anweiteck/2stageCMOSOpAmp/ttsky25a-opamp/docs/info.md

<!---

This file is used to generate your project datasheet. Please fill in the information below and delete any unused
sections.

You can also include images in this folder and reference them in the markdown. Each image must be less than
512 kb in size, and the combined size of all images must be less than 1 MB.
-->

## How it works

Simple 2 stage CMOS Op Amp with Miller compensation.

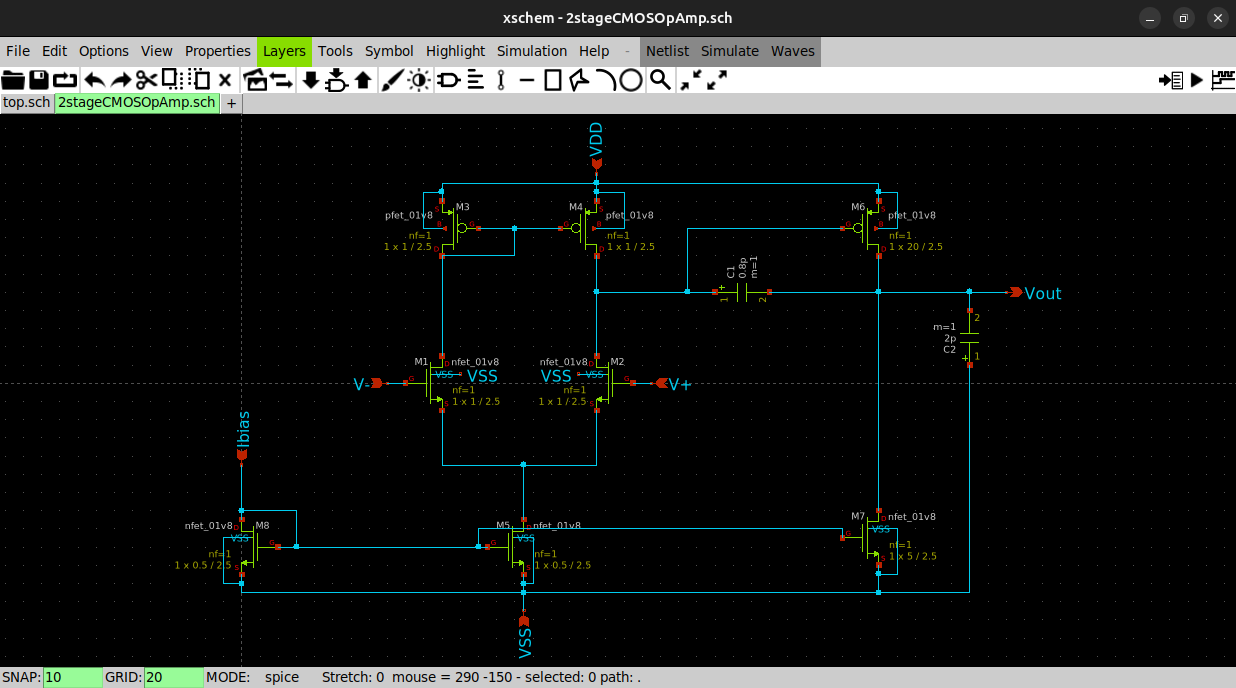
[picture p1: ttsky25a-opamp/schematic.png]
image info


## How to test

- Feed a current of 8uA to Ibias.
- Add a 2pF capacitor to Vout, C2 in the schematic is an external capacitor that needs to be added
- The op amp needs a DC power supply of +1.8V to work
- The differential inputs are V+ and V-, while the output of the op amp is Vout.

## External hardware

No external hardware requried
