anweiteck/2stageCMOSOpAmp/ttsky25a-opamp/test/overview.xlsx

Sheet: parameters
 | calculated | actual
open loop gain | 50 | 50 | dB
open loop PM | 60 | 70 | deg
GBW | 5 | 5 | MHz
SR | 10 | ~8 | V/us

Sheet: effect of C_L
with C_L | w/o C_L
