anweiteck/2stageCMOSOpAmp/ttsky25a-opamp/test/v2_Cc0.5pF/sample_waves/a0.01_f10k_gain100.pdf

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

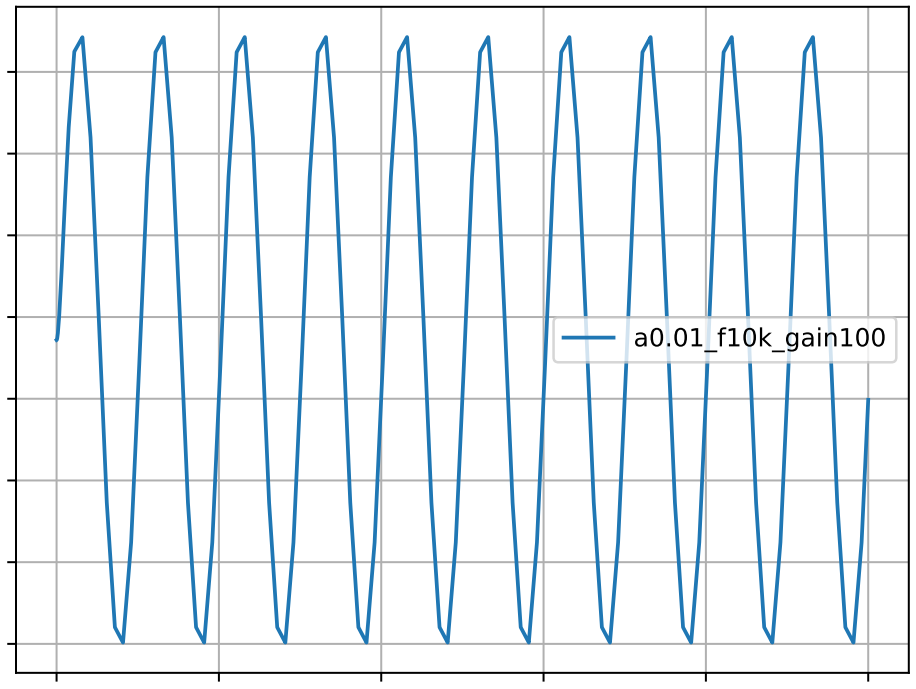
[picture p16: figure]
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
