anweiteck/2stageCMOSOpAmp/ttsky25a-opamp/test/v1_Cc3pF/effect of C_L/Vout no C_L.png

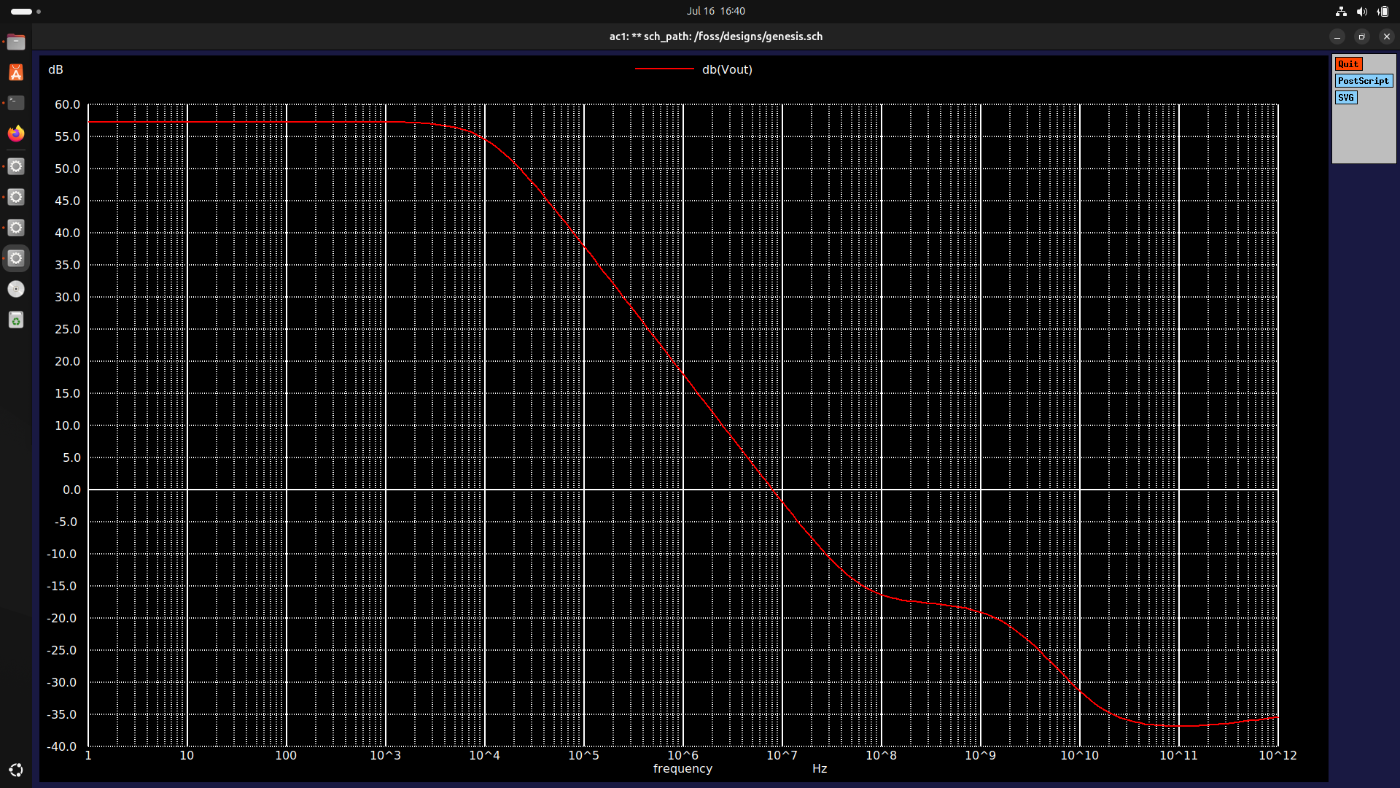
ttsky25a-opamp/test/v1_Cc3pF/effect of C_L/Vout no C_L.png
