anweiteck/2stageCMOSOpAmp/ttsky25a-opamp/test/v2_Cc0.5pF/sample_waves/a0.01_f1k_gain100-1.png

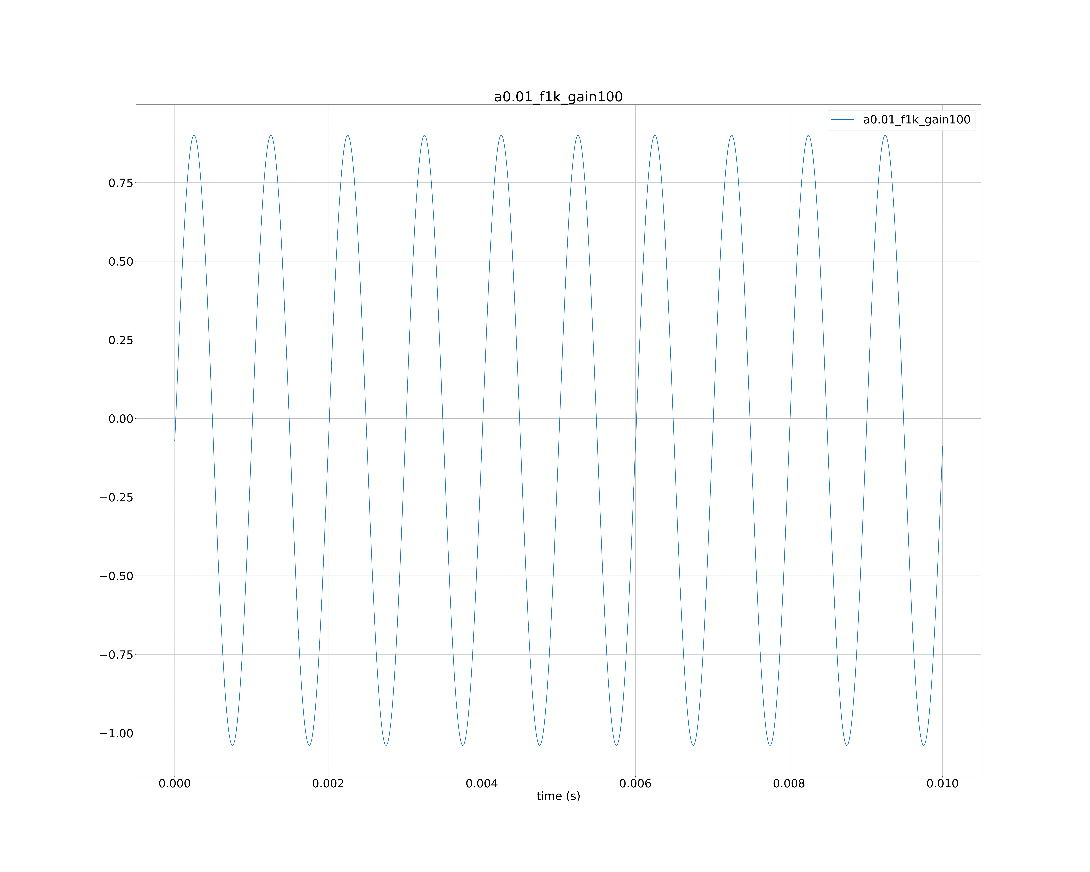
ttsky25a-opamp/test/v2_Cc0.5pF/sample_waves/a0.01_f1k_gain100-1.png
