anweiteck/2stageCMOSOpAmp/ttsky25a-opamp/test/v2_Cc0.5pF/sample_waves/a1.3m_f1k_gain700-1.png

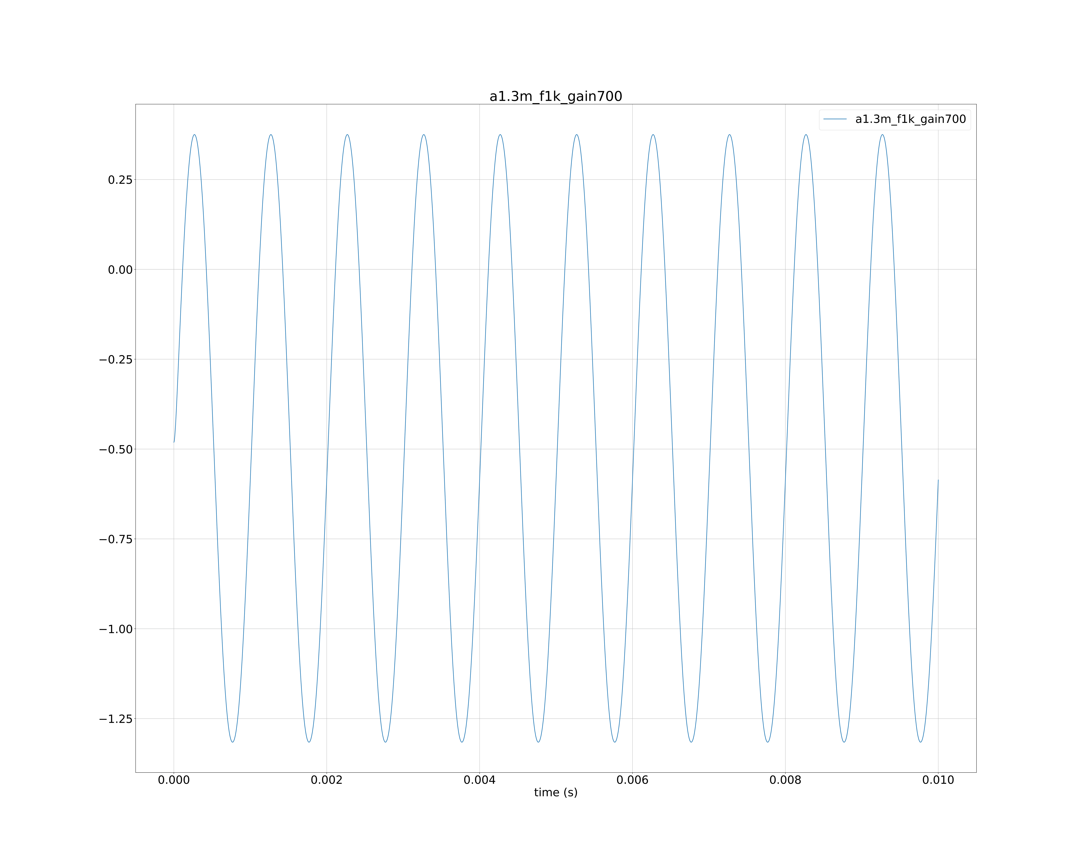
ttsky25a-opamp/test/v2_Cc0.5pF/sample_waves/a1.3m_f1k_gain700-1.png
