anweiteck/2stageCMOSOpAmp/ttsky25a-opamp/test/v3_Cc0.45pF/OpenLoop/open loop gain + PM.png

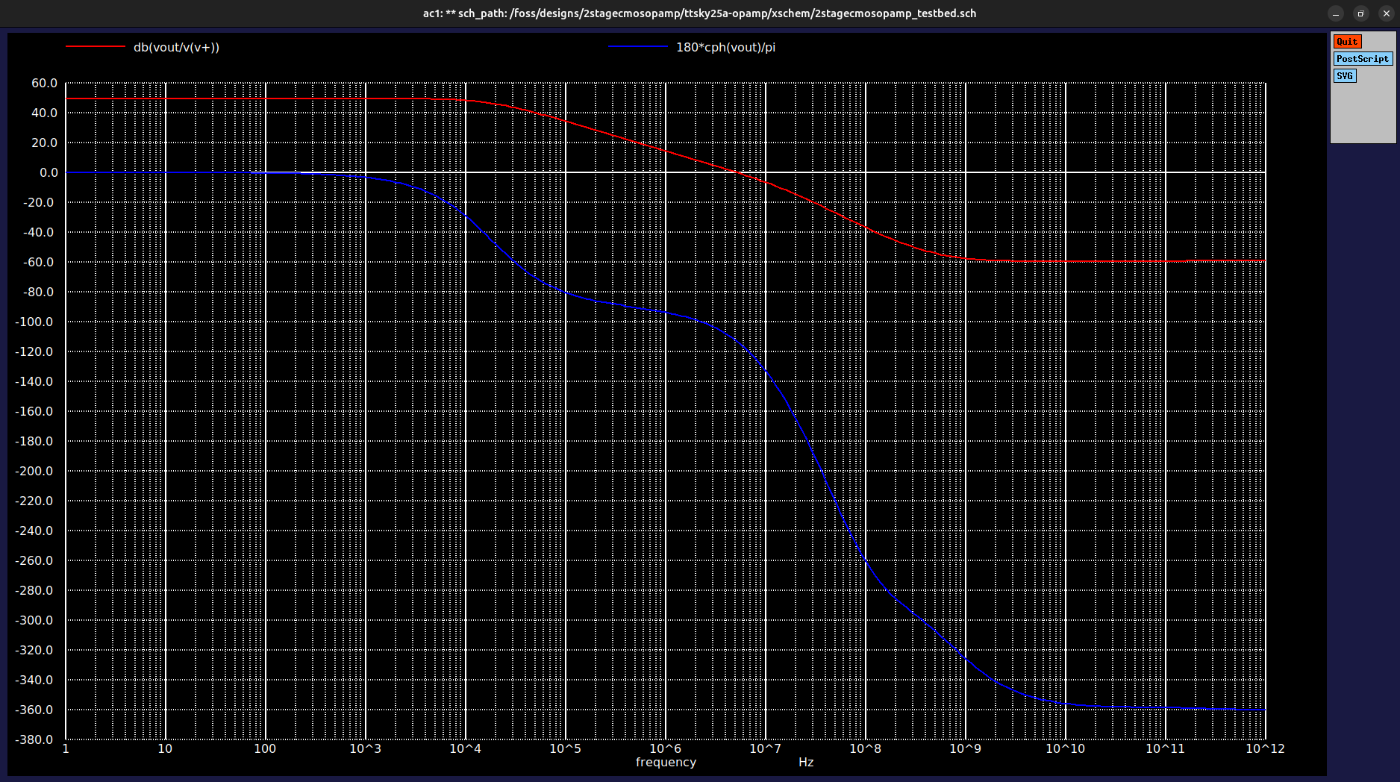
ttsky25a-opamp/test/v3_Cc0.45pF/OpenLoop/open loop gain + PM.png
