anweiteck/2stageCMOSOpAmp/ttsky25a-opamp/test/v4_Cc0.8pF/SR/SR-1.png

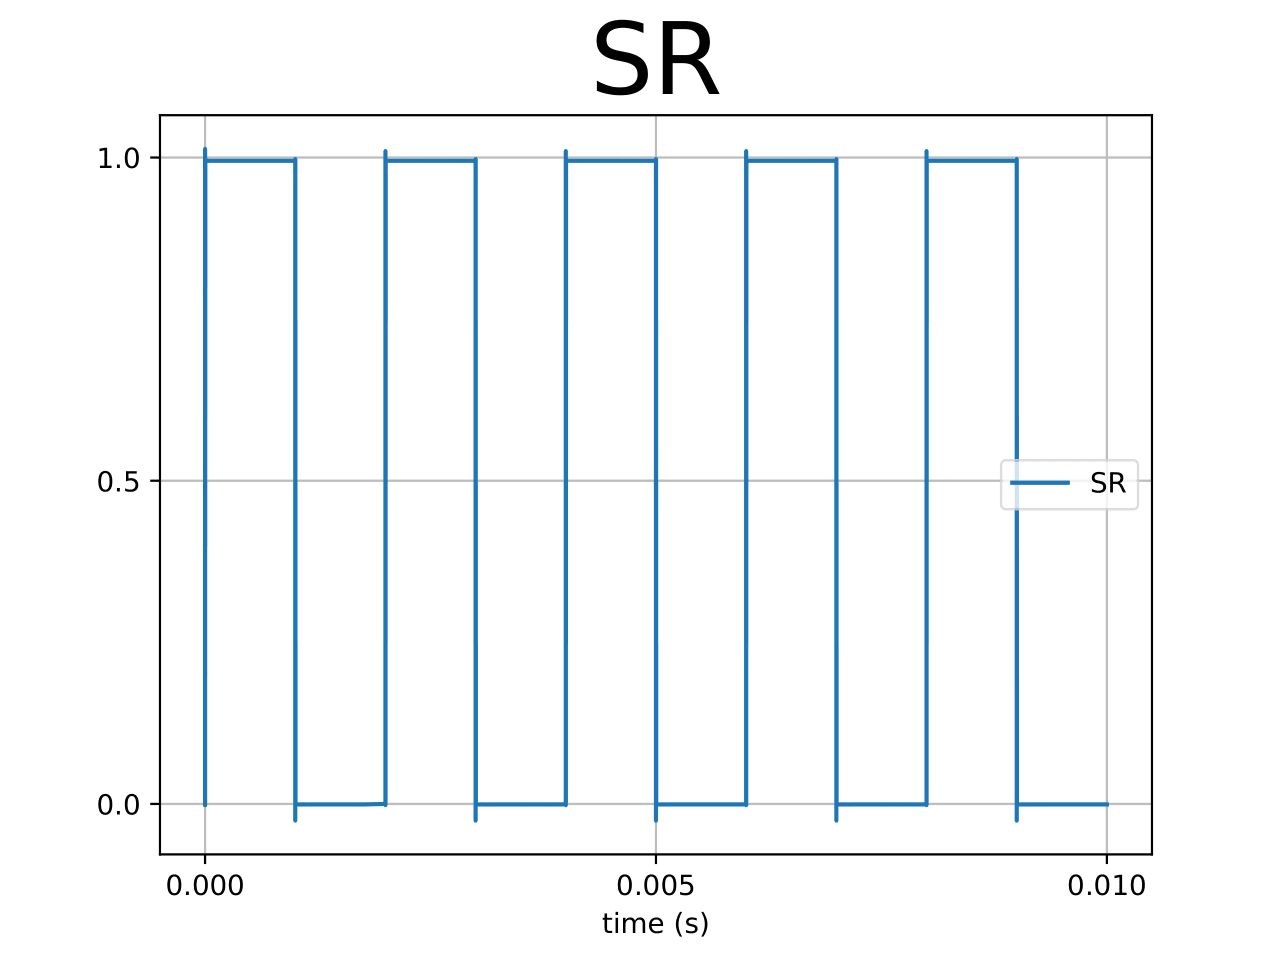
ttsky25a-opamp/test/v4_Cc0.8pF/SR/SR-1.png
