anweiteck/2stageCMOSOpAmp/ttsky25a-opamp/test/v1_Cc3pF/GainvsFreq/Frequency response of different gains.pdf

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

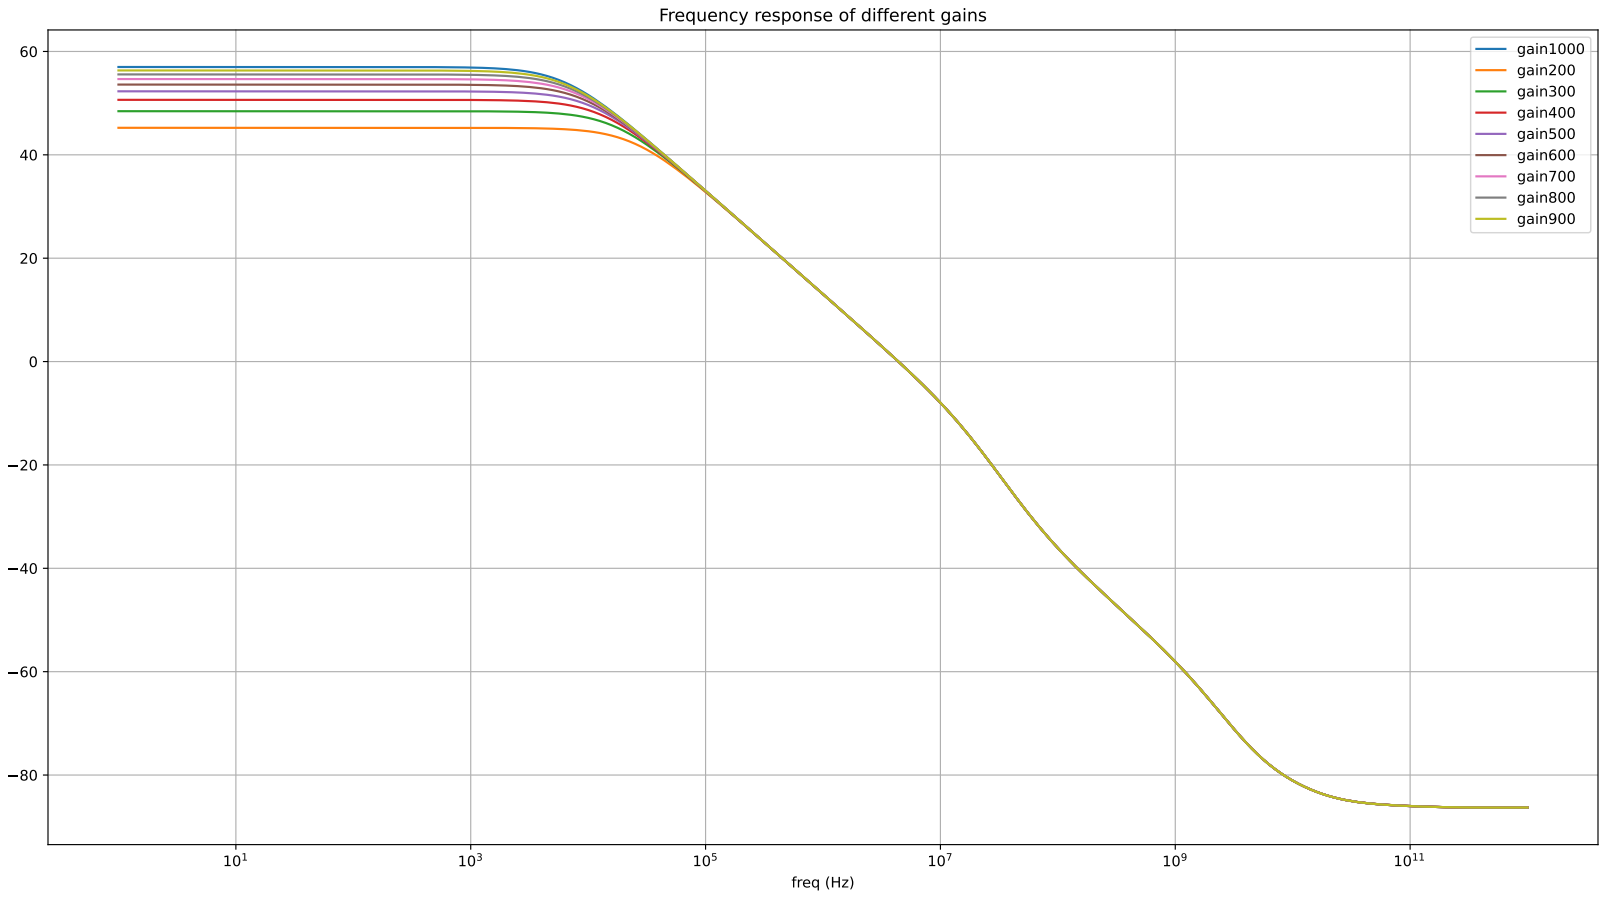
[picture p25: page 1]
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
