anweiteck/2stageCMOSOpAmp/ttsky25a-opamp/test/v2_Cc0.5pF/sample_waves/a2.5m_f1k_gain400.pdf

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

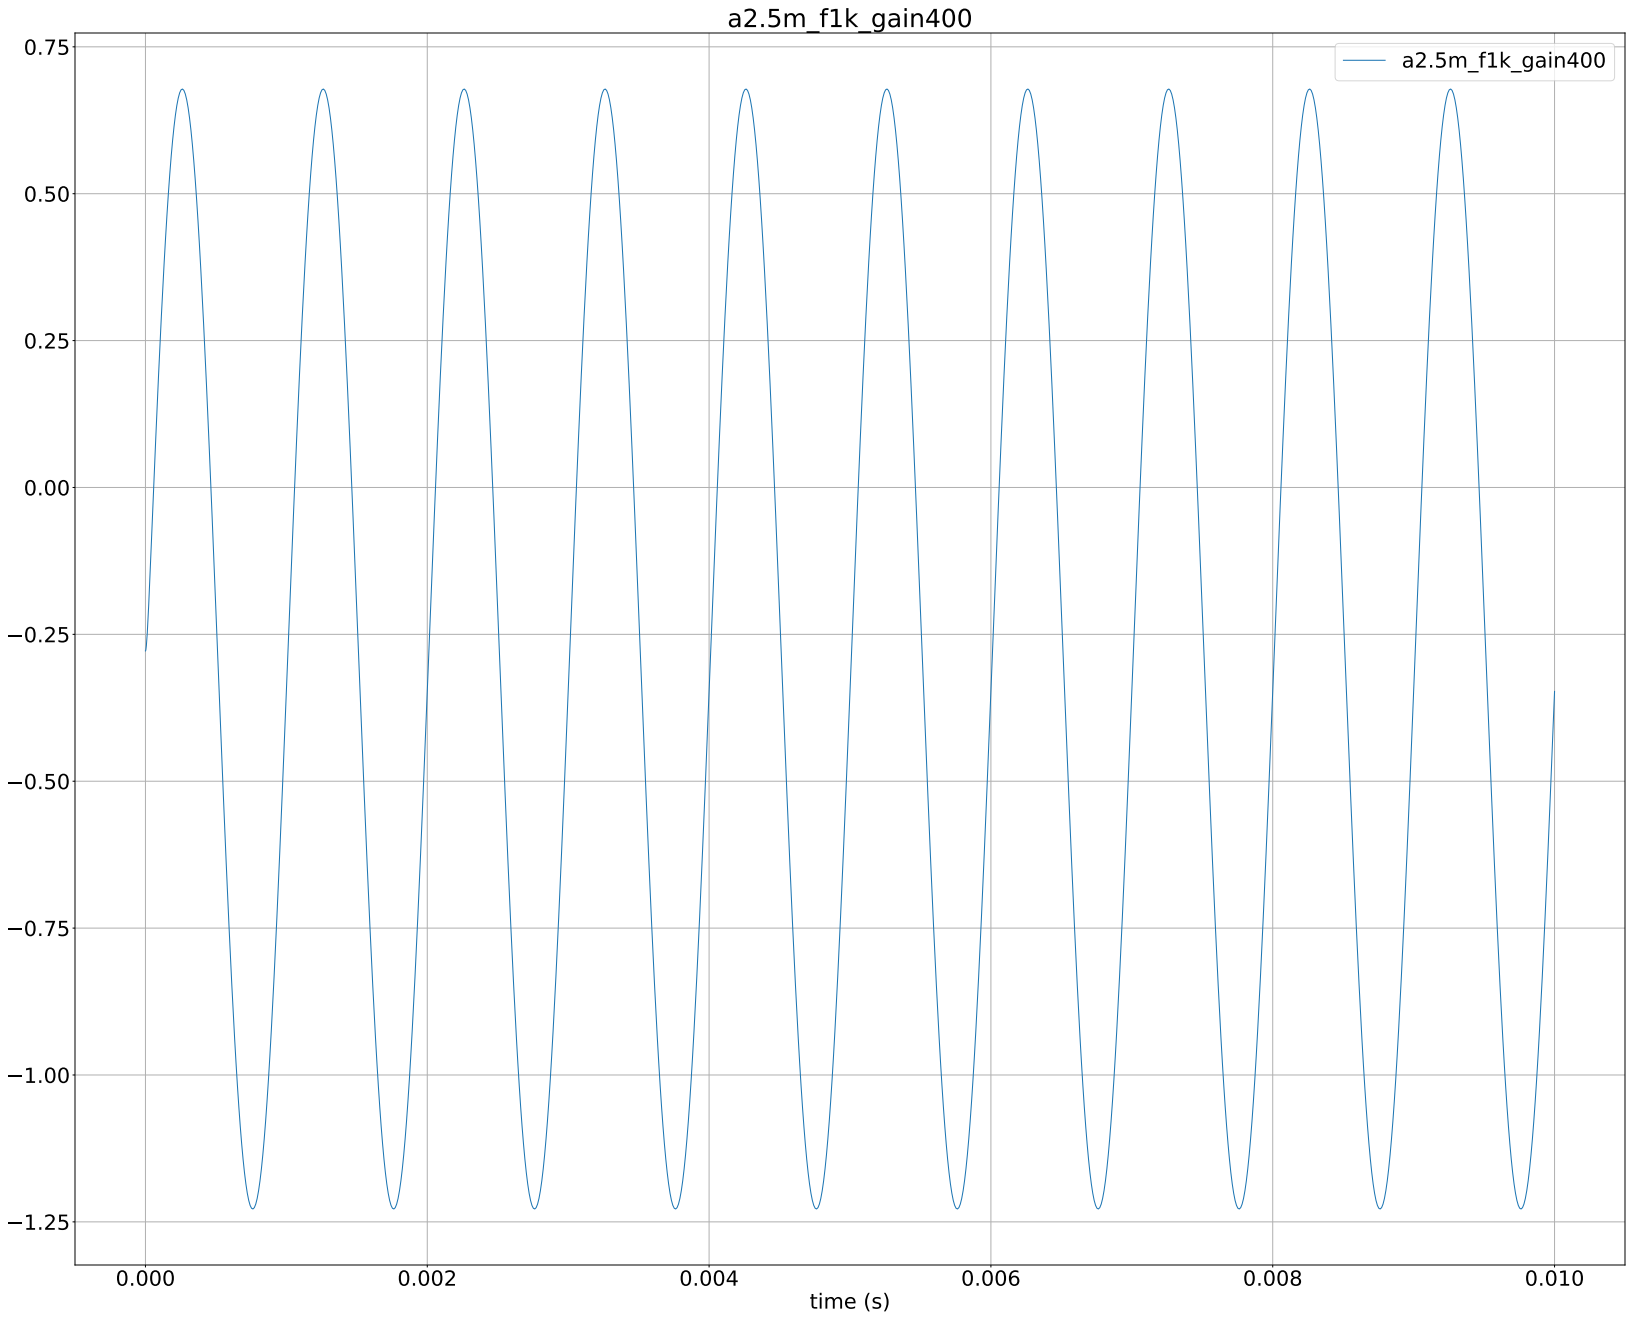
[picture p30: page 1]
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
