anweiteck/2stageCMOSOpAmp/ttsky25a-opamp/test/v3_Cc0.45pF/sample_waves/a1.3m_f10k_gain700.pdf

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

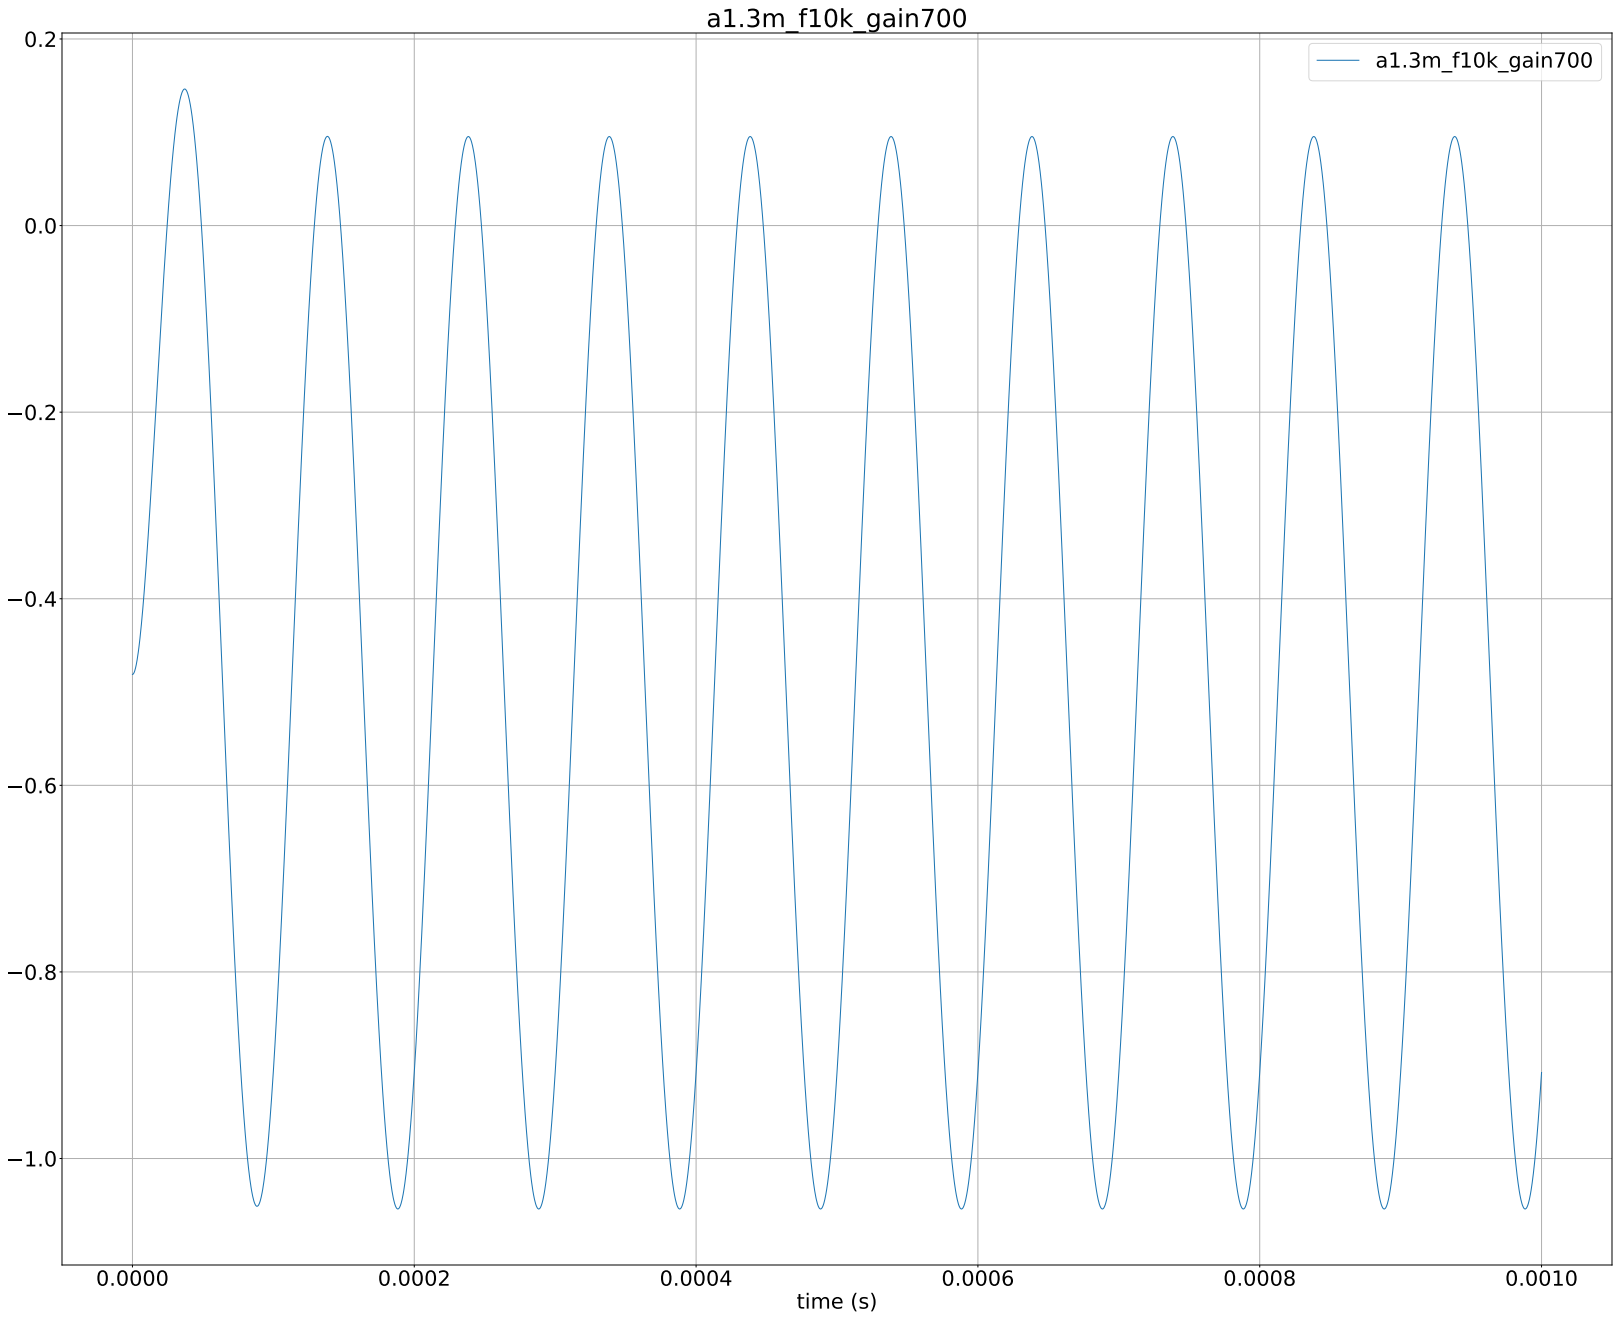
[picture p35: page 1]
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
