anweiteck/2stageCMOSOpAmp/ttsky25a-opamp/test/v3_Cc0.45pF/sample_waves/a2.5m_f1k_gain400.pdf

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

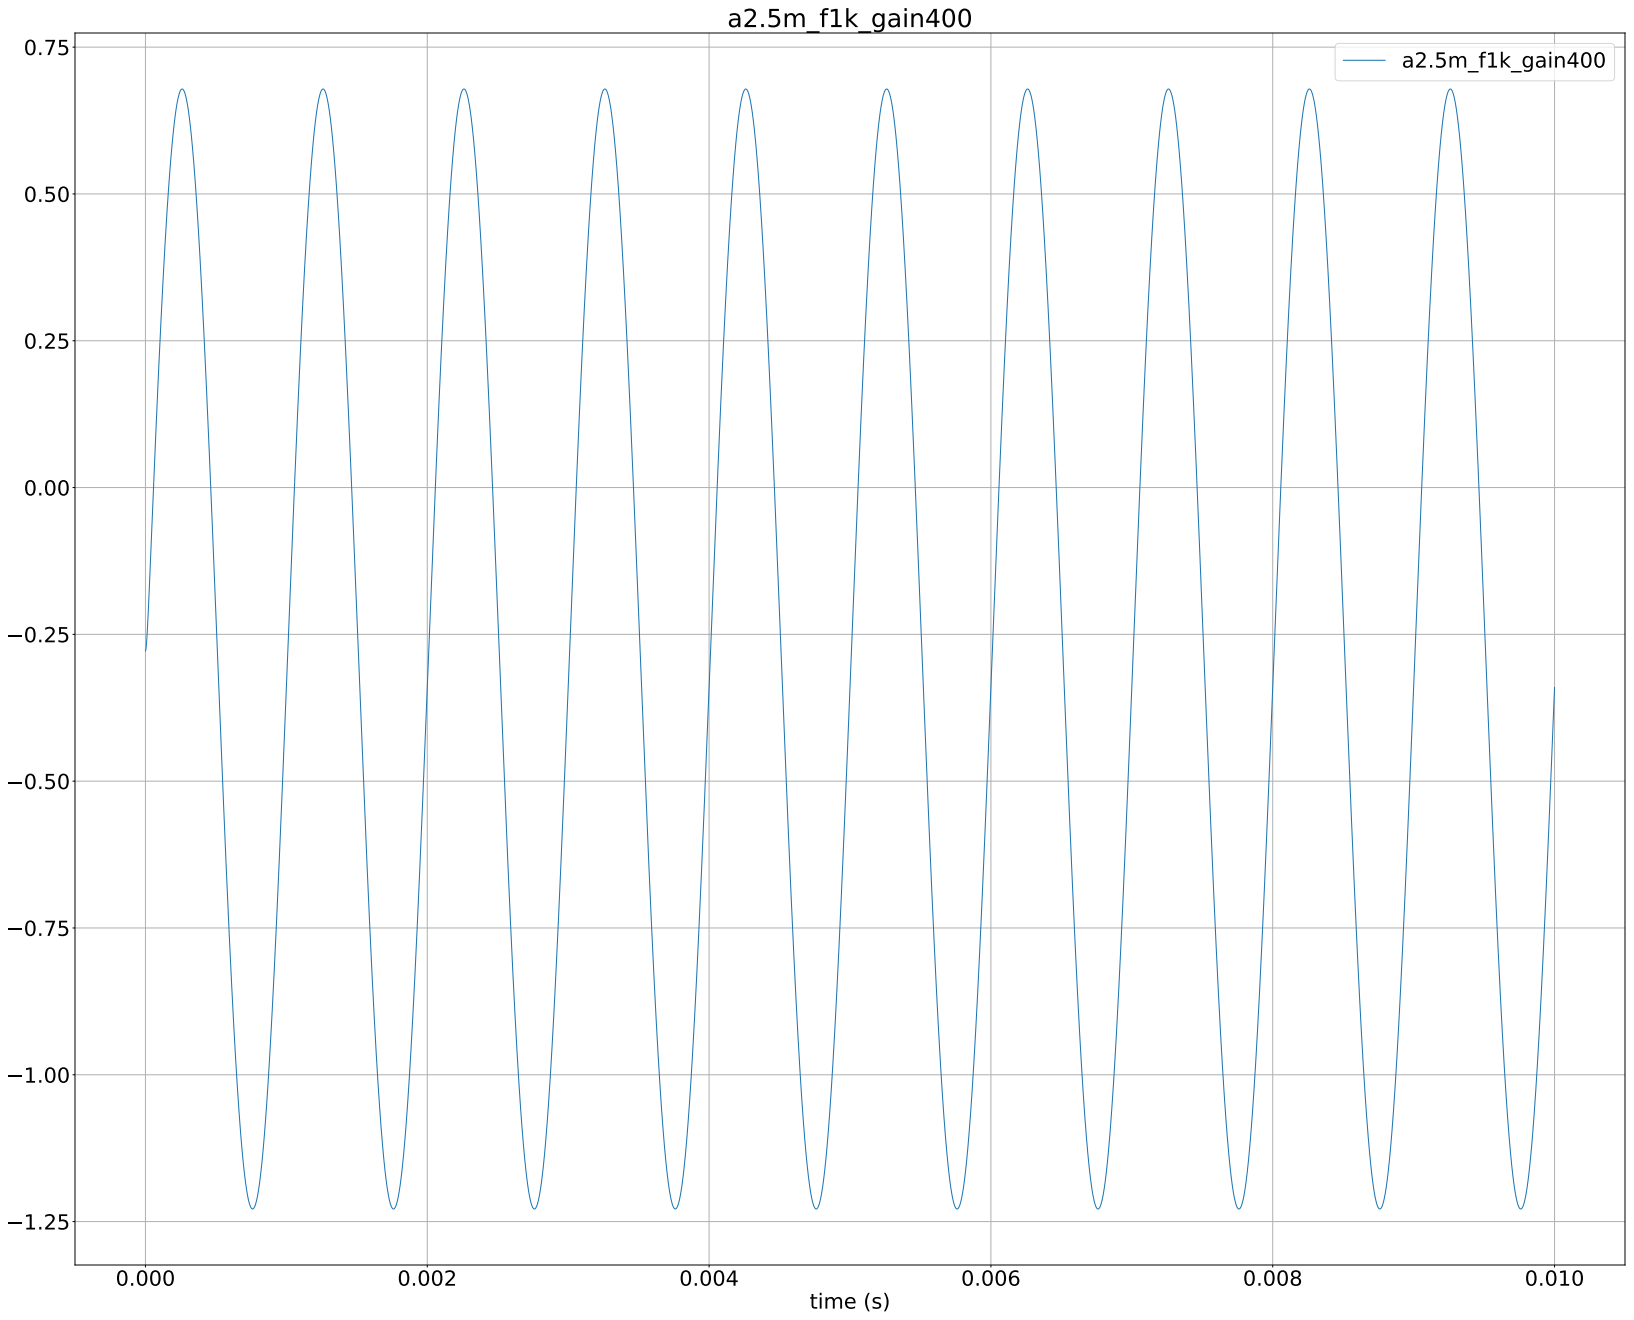
[picture p39: page 1]
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
