anweiteck/2stageCMOSOpAmp/ttsky25a-opamp/test/v3_Cc0.45pF/SR/SR.pdf

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

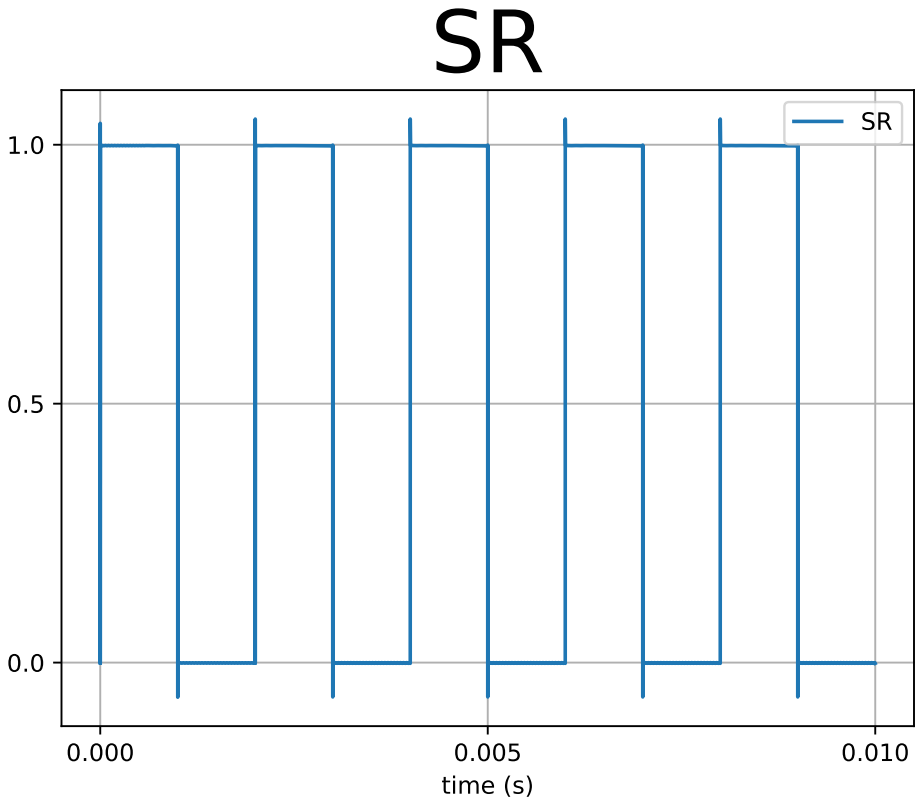
[picture p40: page 1]
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
