anweiteck/2stageCMOSOpAmp/ttsky25a-opamp/test/v4_Cc0.8pF/sample_waves/a0.01_f10k_gain100.pdf

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

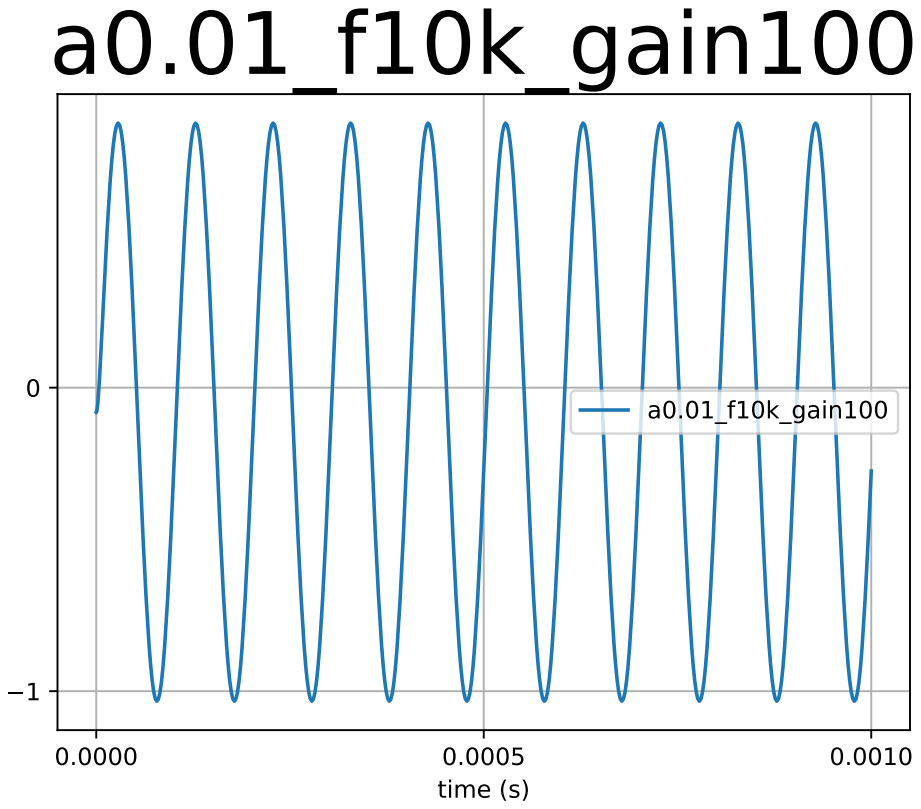
[picture p42: page 1]
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
