anweiteck/2stageCMOSOpAmp/ttsky25a-opamp/test/v4_Cc0.8pF/sample_waves/a1.3m_f1k_gain700.pdf

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

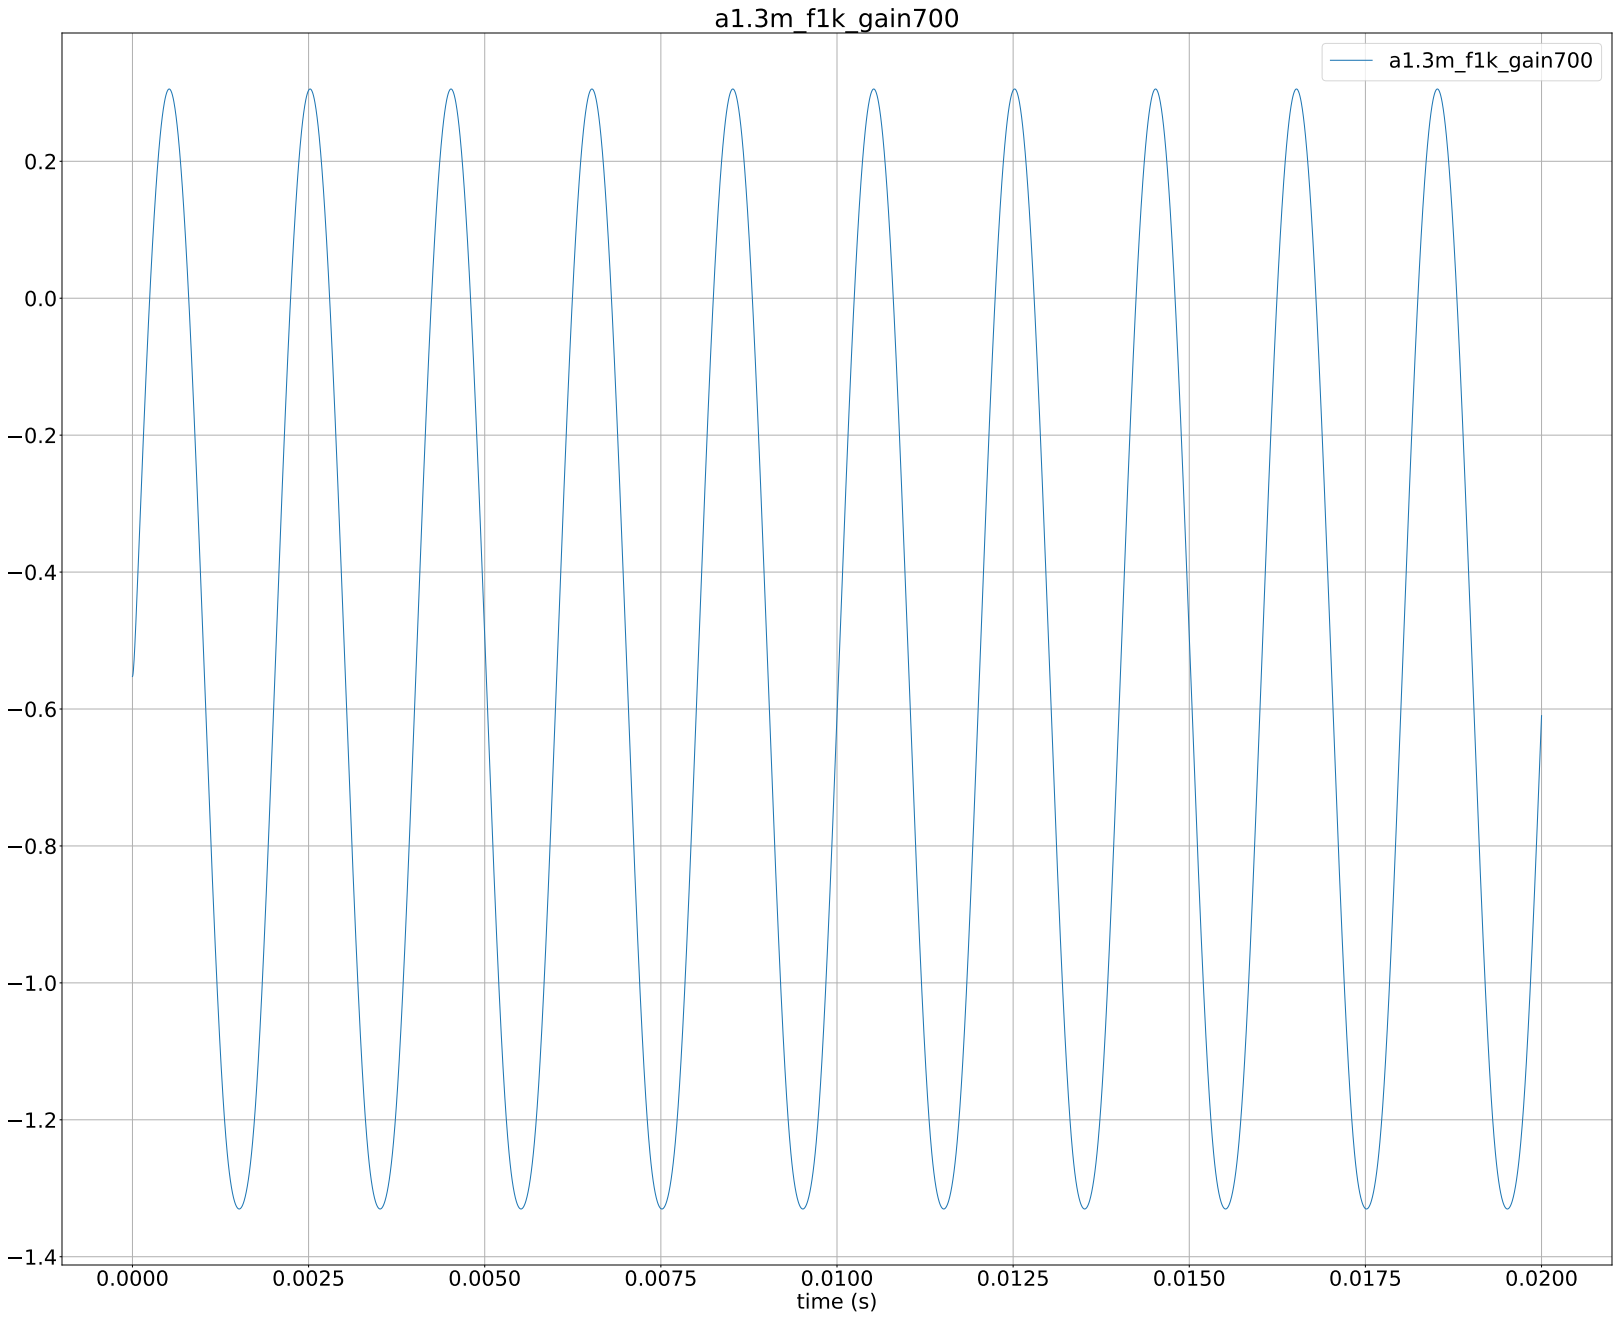
[picture p44: page 1]
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
