anweiteck/2stageCMOSOpAmp/ttsky25a-opamp/test/v4_Cc0.8pF/SR/SR.pdf

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

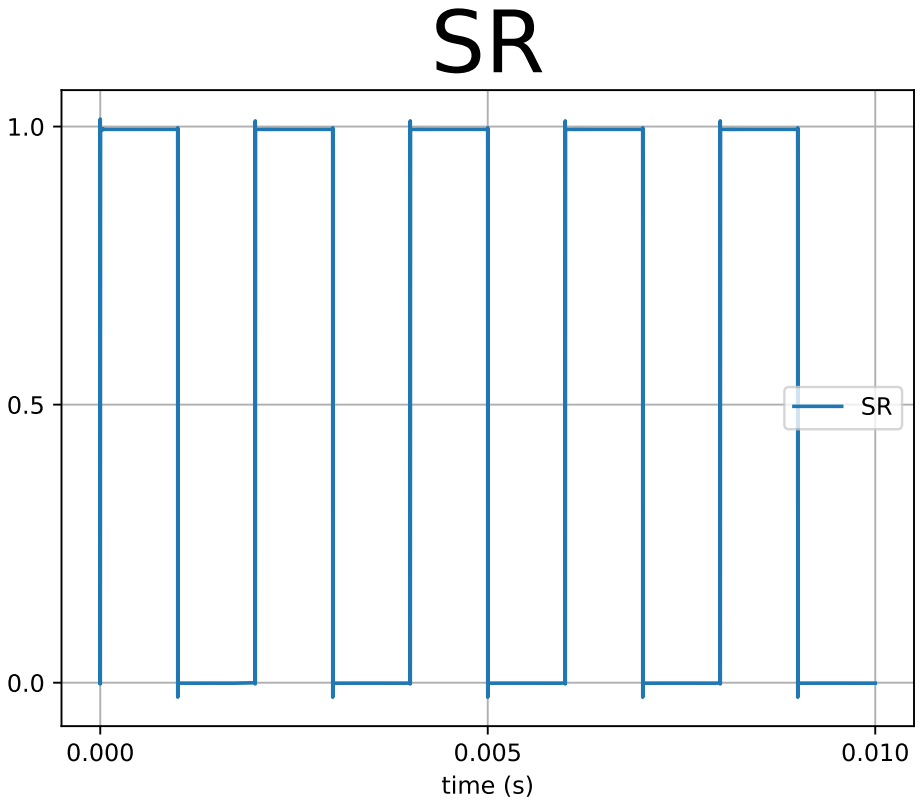
[picture p47: page 1]
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
