anweiteck/2stageCMOSOpAmp/ttsky25a-opamp/test/v4_Cc0.8pF_postlayout/comparisons/a2.5m_f10k_gain400.pdf

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

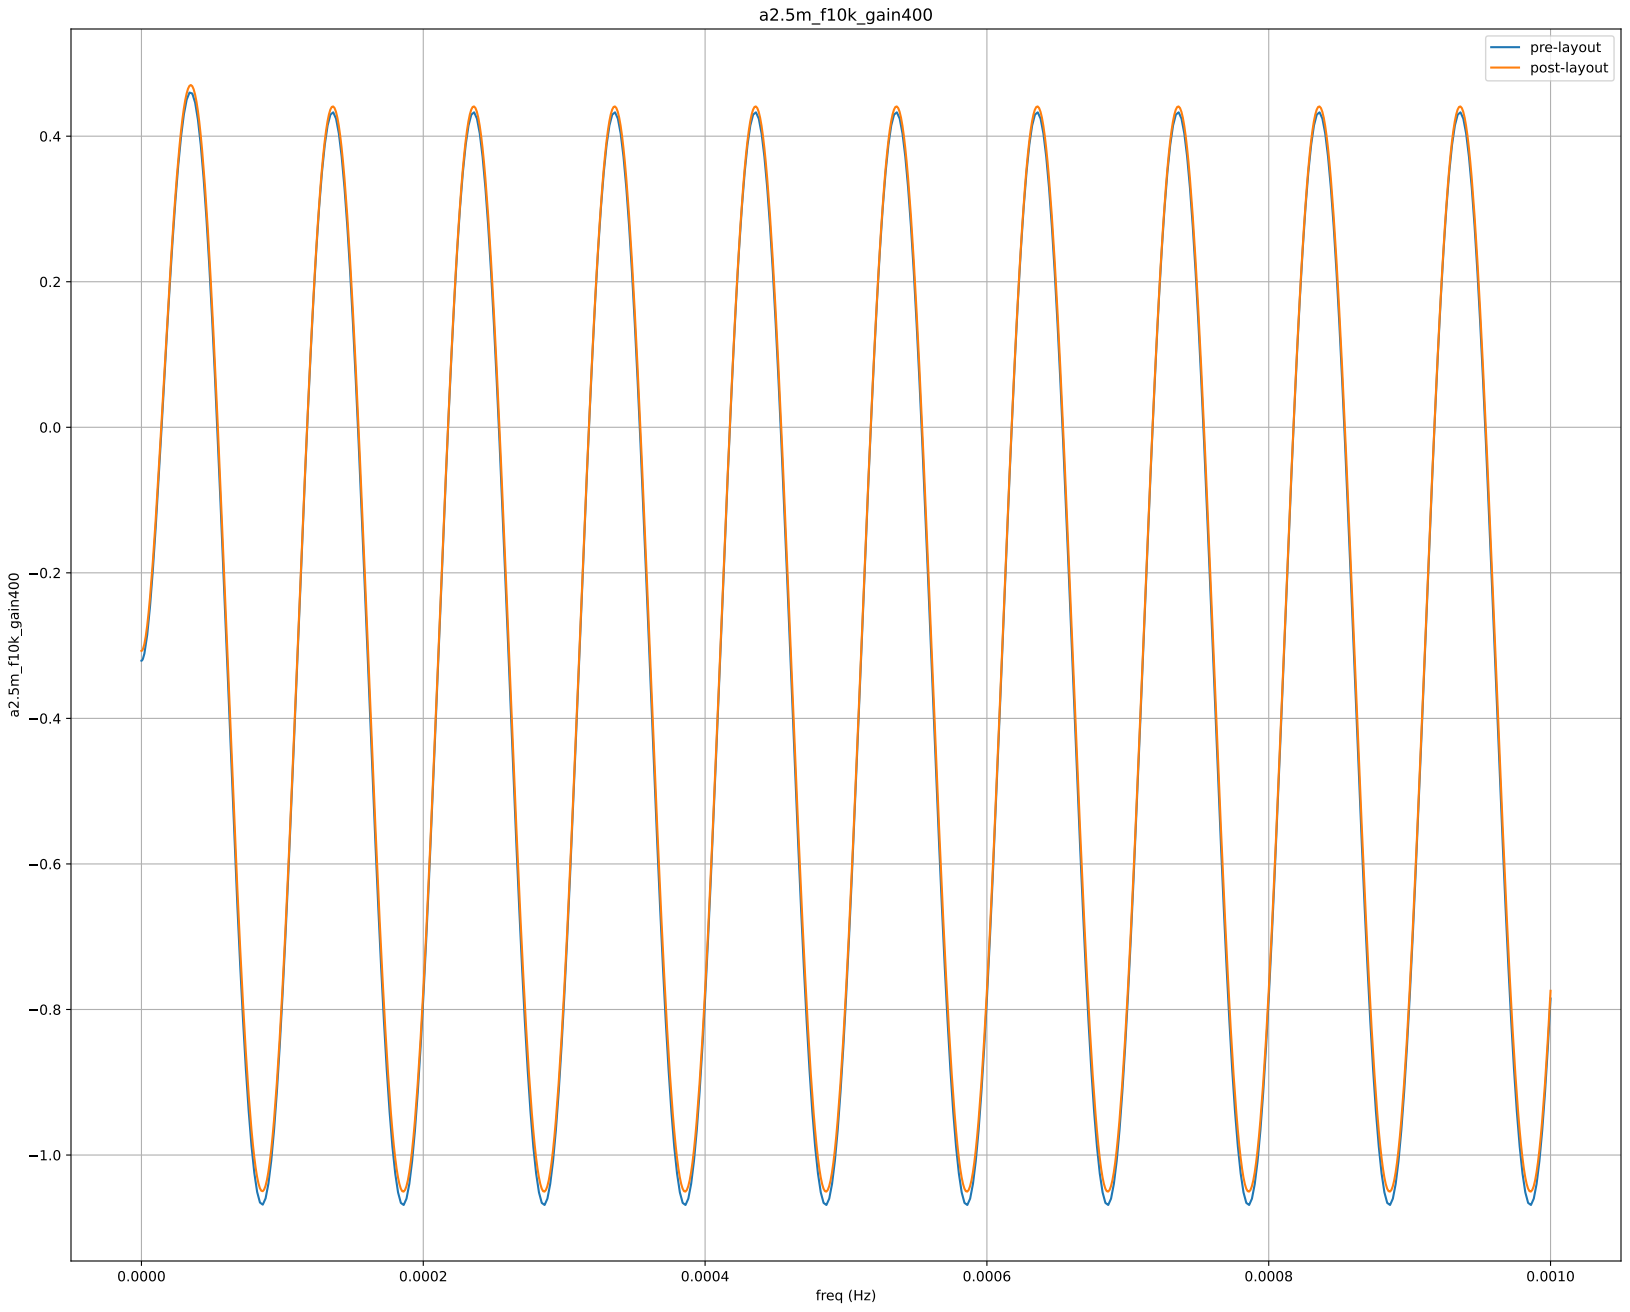
[picture p49: page 1]
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
