anweiteck/2stageCMOSOpAmp/ttsky25a-opamp/test/v4_Cc0.8pF_postlayout/comparisons/gain100.pdf

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

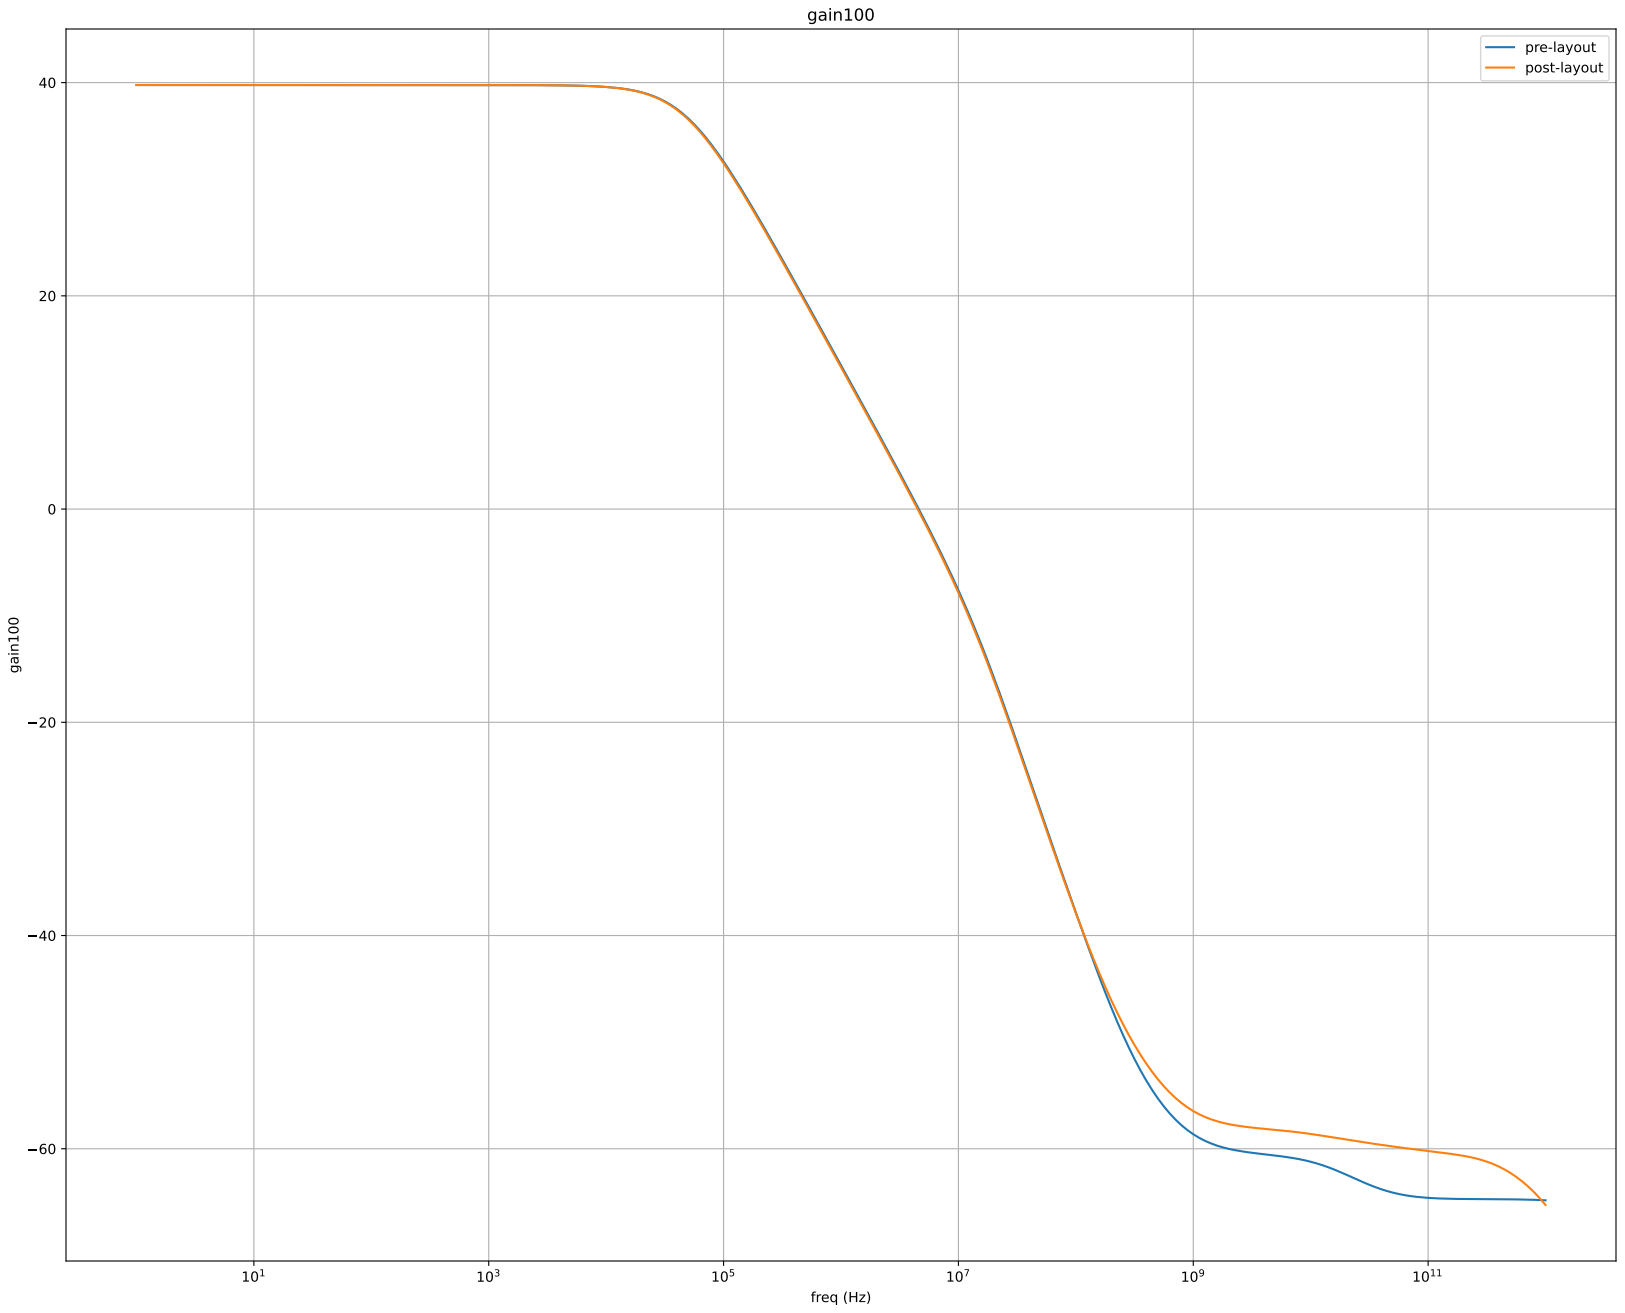
[picture p50: page 1]
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
